odudex/P4Enclosures/crowpanel_101/exports/Case.stl

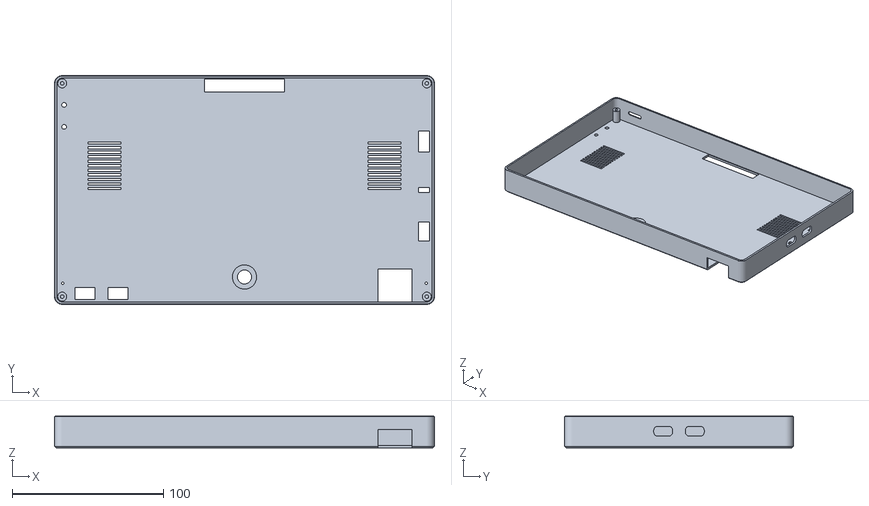
[picture p6: CAD file, 2026-10-30]
crowpanel_101/exports/Case.stl
251.2 x 151.2 x 21.0
