odudex/P4Enclosures/crowpanel_7/exports/Frame.stl

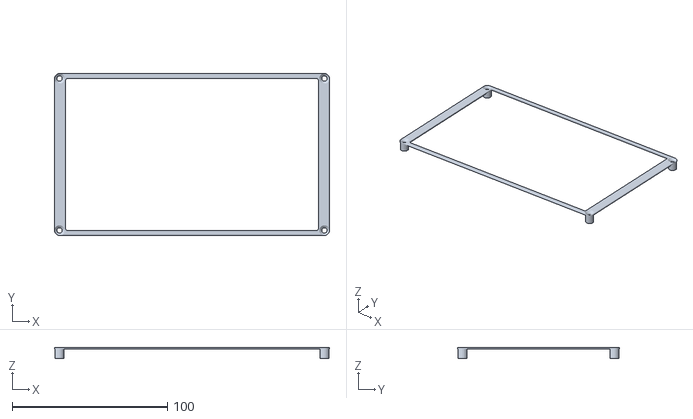
[picture p7: CAD file, 2026-10-30]
crowpanel_7/exports/Frame.stl
177.4 x 104.5 x 7.35
