odudex/P4Enclosures/p4_pico/exports/display_5in_dsi.step

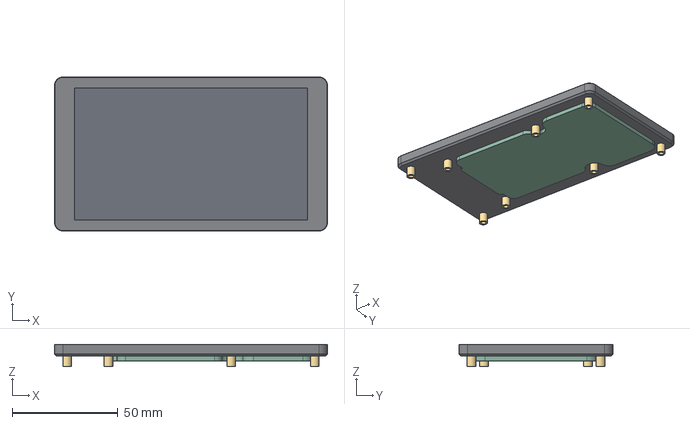
[picture p8: CAD file, 2026-11-05]
p4_pico/exports/display_5in_dsi.step
129.0 x 72.8 x 10.6 mm
