odudex/P4Enclosures/wave_43/exports/wave43_case.3mf

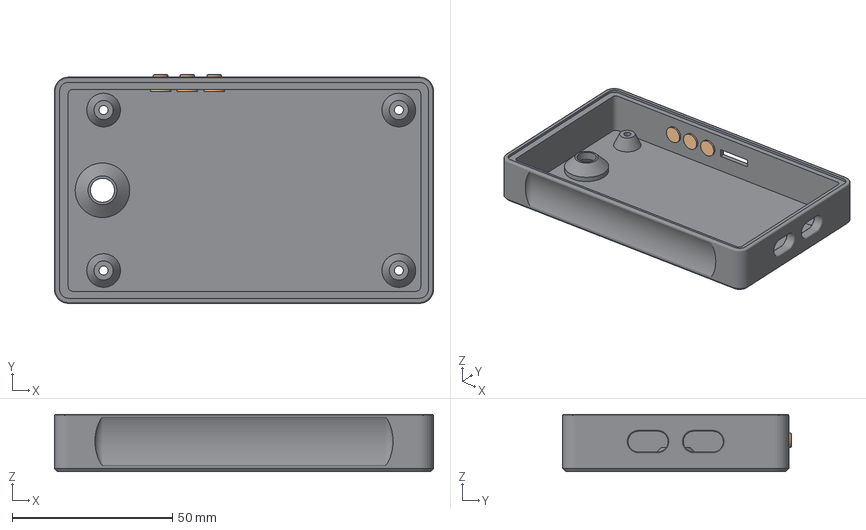
[picture p9: CAD file, 2026-11-05]
wave_43/exports/wave43_case.3mf
118.1 x 71.3 x 17.9 mm
Case
Button1
Button2
Button3
