odudex/P4Enclosures/wave_5/exports/wave5_case.3mf

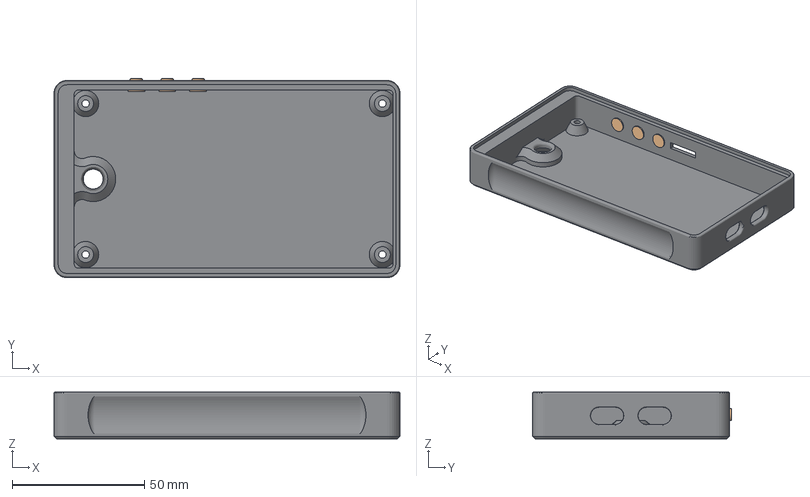
[picture p10: CAD file, 2026-11-05]
wave_5/exports/wave5_case.3mf
130.6 x 75.2 x 17.7 mm
Case
Button1
Button2
Button3
