odudex/P4Enclosures/crowpanel_101/exports/crowpanel_101_case.3mf

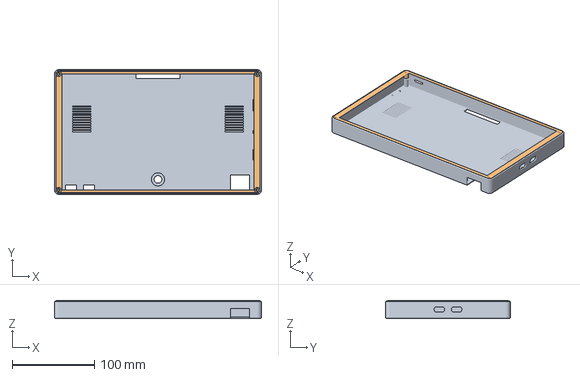
[picture p11: CAD file, 2026-10-30]
crowpanel_101/exports/crowpanel_101_case.3mf
251.2 x 151.2 x 22.0 mm
Case
Frame
