odudex/P4Enclosures/crowpanel_7/exports/Case.stl

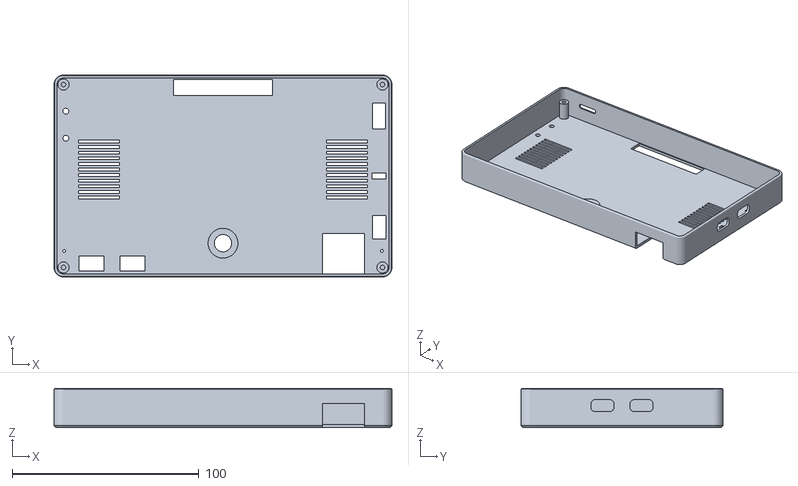
[picture p12: CAD file, 2026-10-30]
crowpanel_7/exports/Case.stl
181.1 x 108.2 x 20.9
