odudex/P4Enclosures/p4_pico/exports/BackShell.3mf

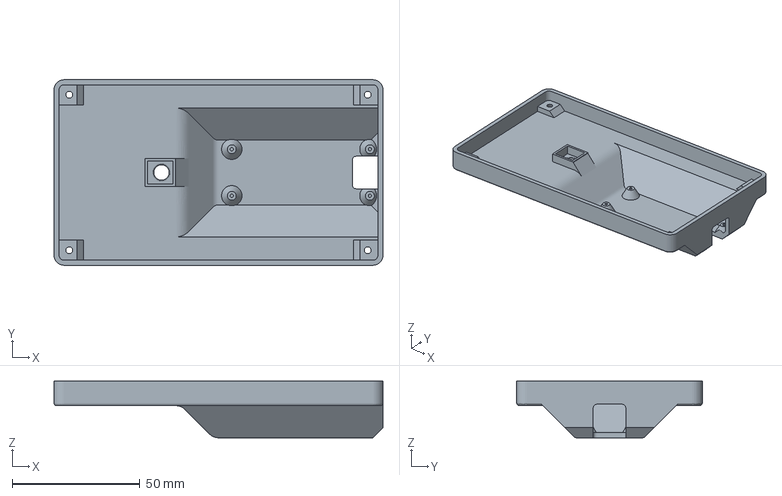
[picture p13: CAD file, 2026-11-05]
p4_pico/exports/BackShell.3mf
129.0 x 72.8 x 22.2 mm
