odudex/P4Enclosures/wave_43/exports/Case.stl

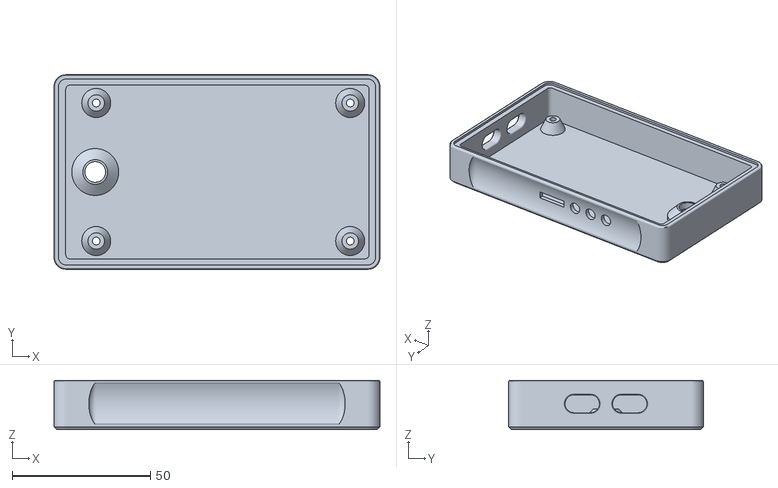
[picture p14: CAD file, 2026-11-05]
wave_43/exports/Case.stl
118.1 x 70.5 x 17.9
