odudex/P4Enclosures/wave_5/exports/Case.stl

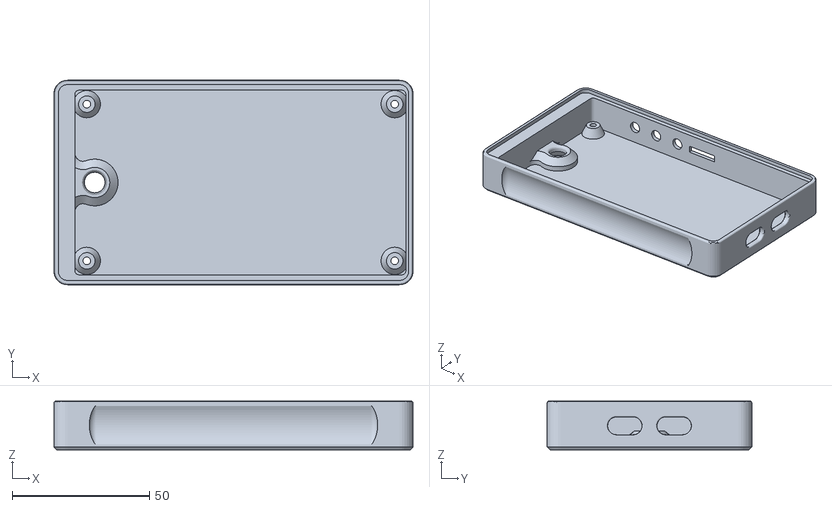
[picture p15: CAD file, 2026-11-05]
wave_5/exports/Case.stl
130.6 x 74.4 x 17.7
