odudex/P4Enclosures/crowpanel_101/exports/Frame.stl

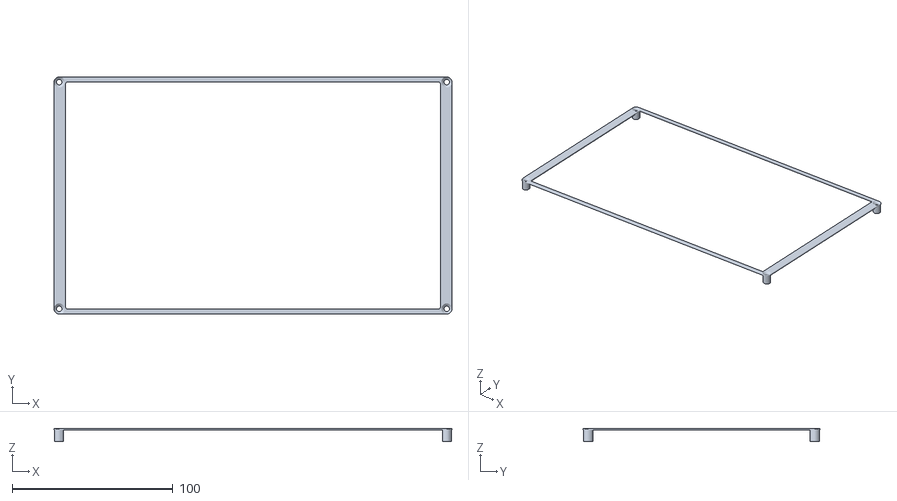
[picture p16: CAD file, 2026-10-30]
crowpanel_101/exports/Frame.stl
247.5 x 147.5 x 8.15
