odudex/P4Enclosures/crowpanel_7/exports/crowpanel_7_case.3mf

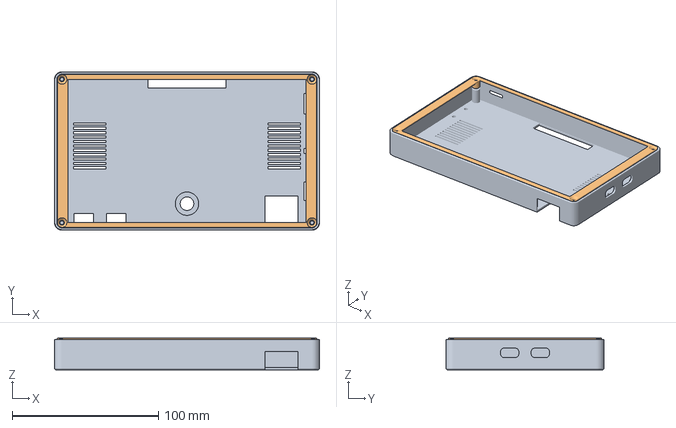
[picture p17: CAD file, 2026-10-30]
crowpanel_7/exports/crowpanel_7_case.3mf
181.1 x 108.2 x 21.9 mm
Case
Frame
