odudex/P4Enclosures/wave_43/exports/Button.stl

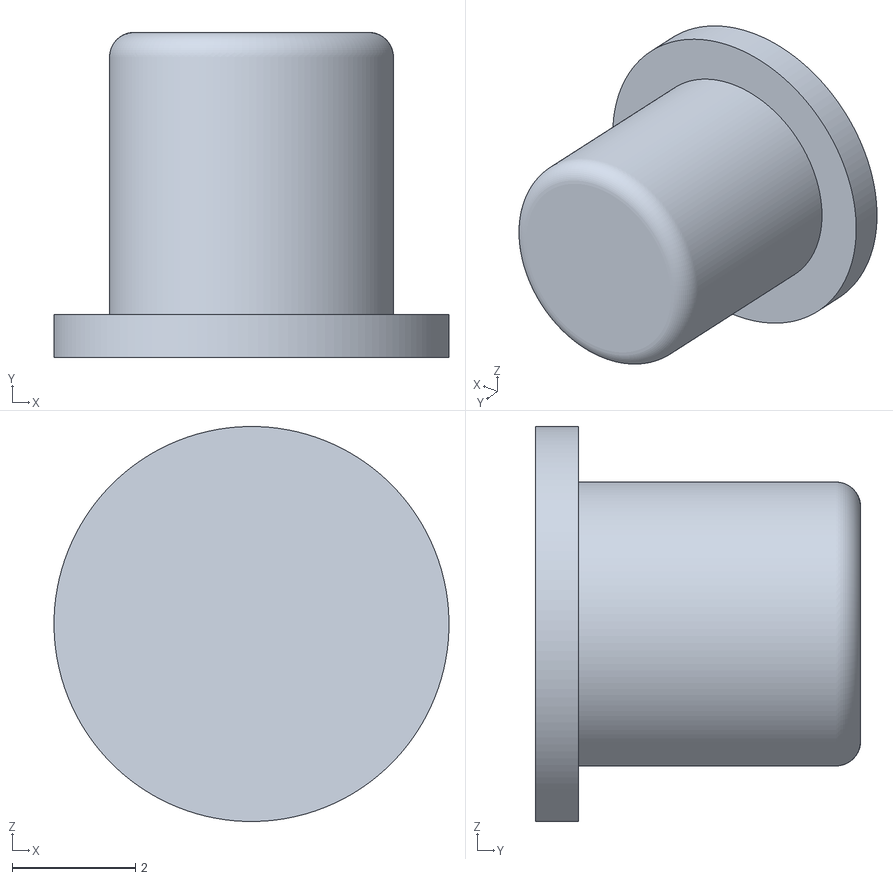
[picture p18: CAD file, 2026-11-05]
wave_43/exports/Button.stl
6.40 x 5.27 x 6.40
