odudex/P4Enclosures/wave_5/exports/Button.stl

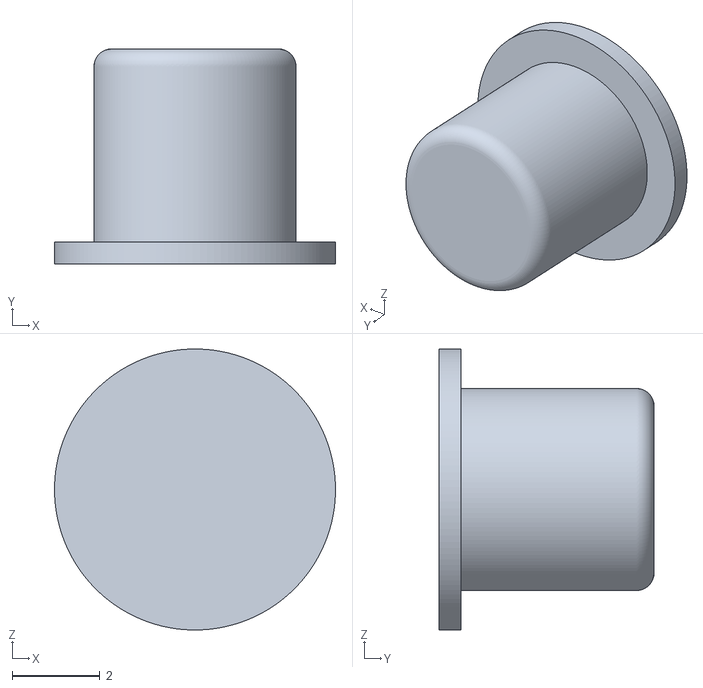
[picture p19: CAD file, 2026-11-05]
wave_5/exports/Button.stl
6.40 x 4.90 x 6.40
