odudex/P4Enclosures/(list of files, cad)

Other CAD files:
p4_pico/exports/BackShell.stl
