odudex/P4Enclosures/(commit log)

2026-10-30 Initial commit: P4Enclosures, enclosures for ESP32-P4 Kern devices
    One repository for the 3D-printable enclosures of ESP32-P4-based Kern
    devices, modelled in SolidCraft. Each device has its own folder, named
    after its Kern designation:
    - p4_pico/: back shell for an ESP32-P4-Pico board and a 5" DSI touch
    display (previously the PicoEnclosure repository). Printed and tested.
    - wave_5/: one-piece case and button plungers for the Waveshare
    ESP32-P4-WIFI6-Touch-LCD-5 (previously Wave5Enclosure, not in git).
    The root README lists the enclosures and their shared layout and
    conventions. Each folder's README describes the part and its parts list.
    The MIT license moves to the root.
    Vendor mater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
    [BackShell.3mf, BackShell.stl, Button.stl, Case.stl, display_5in_dsi.step, wave5_case.3mf]
2026-10-30 Add assembly renders to the READMEs
    Each enclosure gets images/assembly.png, a render of its assembly seen
    from behind, made in SolidCraft. The root README shows both side by side
    under the enclosures table, and each folder's Files table lists the
    image.
2026-10-30 Add wave_43 enclosure for the Waveshare ESP32-P4-WIFI6-Touch-LCD-4.3
    wave_5's parametric case resized to the 4.3" board: the same design,
    with every board-derived parameter measured again on the vendor STEP.
    Kern's FreeCAD case for this board was the cross-check and gives the
    camera position.
    Differences forced by the board: the glass is only 0.55 mm thick at its
    border, so the shelf sits under that border; the USB-C ports sit
    2.25 mm inside the glass edge, so that wall is about 4 mm thick; the
    screw heads sit 3.6 mm deep, so M2.5x6 screws still get 3 mm of thread.
    An interference check of the assembly against the full board model
    found no overlaps.
    Adds the case design, print exports, an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
    [Button.stl, Case.stl, wave43_case.3mf]
2026-10-30 Add crowpanel_7 enclosure for the CrowPanel Advanced 7"
    Enclosure for the Elecrow CrowPanel Advanced 7" ESP32-P4, the 7" panel
    of Kern's crowpanel target. It follows the FreeCAD case for the 10.1"
    CrowPanel that 3rdIteration made for Kern: a back case and a front
    frame clamp the PCB with four M3x16 flat-head self-tapping screws
    through its corner holes, and the rear connectors are reached through
    openings in the back. Two speaker grilles sit over the PCB's two
    cutouts, the USB-C ports and microSD slot open through the side walls,
    and the camera faces backwards from a holder in the back.
    An interference check of the assembly against the board model found no
    overlaps. The board model and the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
    [Case.stl, Frame.stl, crowpanel_7_case.3mf]
2026-10-30 Credit Filputt's FreeCAD case as wave_43's reference
    The wave_43 README now names Filputt as the author of the FreeCAD case
    for the 4.3" board in Kern's repository, which served as the
    cross-check and the source of the camera position.
2026-10-30 Add crowpanel_101 enclosure for the CrowPanel Advanced 10.1"
    Enclosure for the Elecrow CrowPanel Advanced 10.1" ESP32-P4, the 10.1"
    panel of Kern's crowpanel target. It is the crowpanel_7 design with the
    board values measured again on the 10.1" vendor STEP, and it follows
    the FreeCAD case for this panel that 3rdIteration made for Kern: its
    outside size is within 0.3 mm of that case, and its back openings and
    speaker grilles land where that case has them.
    overlaps. The board model and the assembly embed the vendor STEP and
    stay local.
    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
    [Case.stl, Frame.stl, crowpanel_101_case.3mf]
2026-11-05 fix: camera hole position
2026-11-05 wave_5: add side recesses for the microSD card, buttons and grip
    A 2 mm deep scallop along the +Y wall, from the glass shelf to 2 mm above
    the back face and rounded at both ends, makes the microSD card and the
    buttons easier to reach; mirrored onto the -Y wall it is a grip. It
    replaces the microSD slot chamfer, and the unused sd_chamfer parameter is
    removed.
    The recess is driven by side_recess_depth, side_recess_x and
    side_recess_bottom, with every sketch point an expression (dof 0). Each
    round end is a 90 deg revolve about an axis 0.5 mm outside the wall, so
    the profile never touches the axis: a profile edge on the axis leaves a
    pole that SMLib refused as soon as wall or the glass size cha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
    [Button.stl, Case.stl, wave5_case.3mf]
2026-11-05 wave_43: repair edges lost in SolidCraft 0.40, add the side recesses
    SolidCraft 0.40 no longer resolved the edges picked by CameraHolderCone,
    Button1Round-Button3Round and ScrewSeats. They are re-picked at wave_43's
    own positions, and the volumes match the 2026-10-30 build again.
    SdSlotChamfer failed as well. As on wave_5, it is replaced by the side
    recesses, built the same way and driven by the same three parameters;
    sd_chamfer is removed and sd_w's comment updated.
    Exports and the render are refreshed.
    [Button.stl, Case.stl, wave43_case.3mf]
2026-11-05 p4_pico: re-export the parts and the render
    BackShell.stl and BackShell.3mf now match back_shell.sc, including the keel
    end chamfer from 2f7b0bc. display_5in_dsi.step is the same model (same
    bodies and volume) written by SolidCraft 0.40.
    [BackShell.3mf, BackShell.stl, display_5in_dsi.step]
